Lucaa02/hexatones/Images/BongoCat.jpg

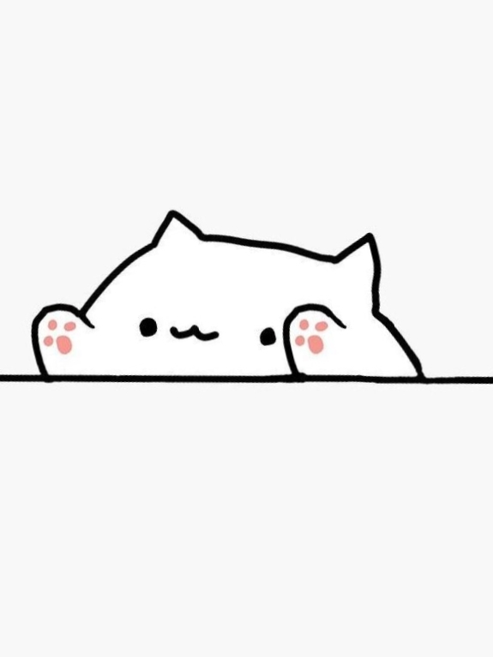
Images/BongoCat.jpg
