Lucaa02/hexatones/Oscillator/Oscillator.pdf

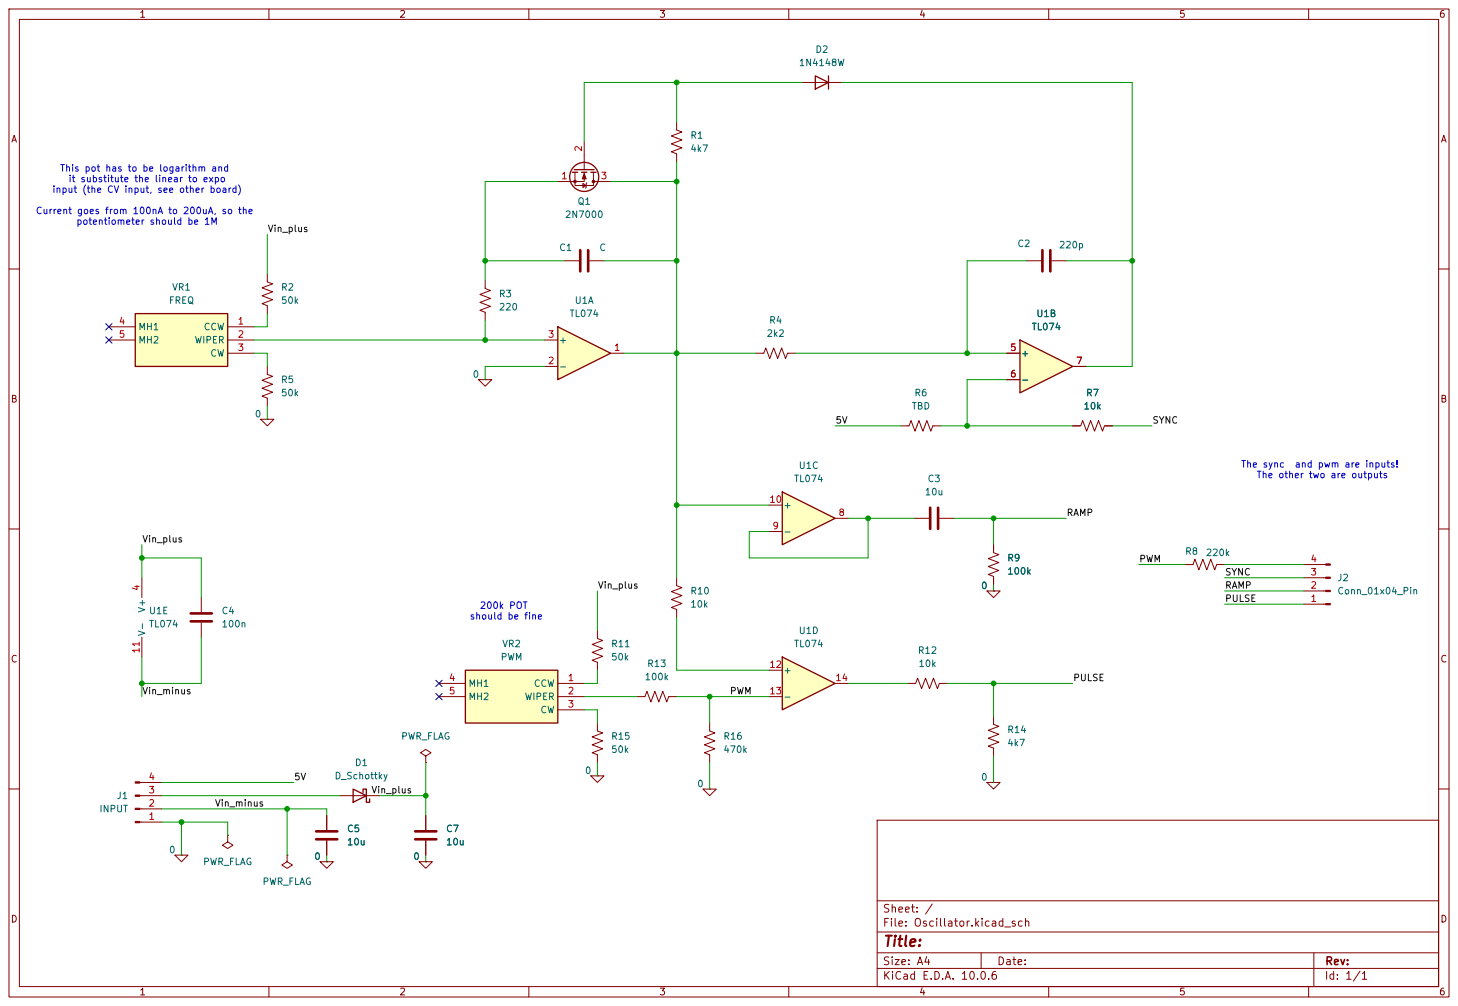
[picture p2: page 1]

This pot has to be logarithm and
it substitute the linear to expo
input (the CV input, see other board) Current goes from 100nA to 200uA, so the potentiometer should be 1M

The sync and pwm are inputs!
The other two are outputs

Size: A4 | Rev:
KiCad E.D.A. 10.0.6 | Id: 1/1
