Lucaa02/hexatones/DCDC/dc-dc-gerbers/dc-dc-schematic.pdf

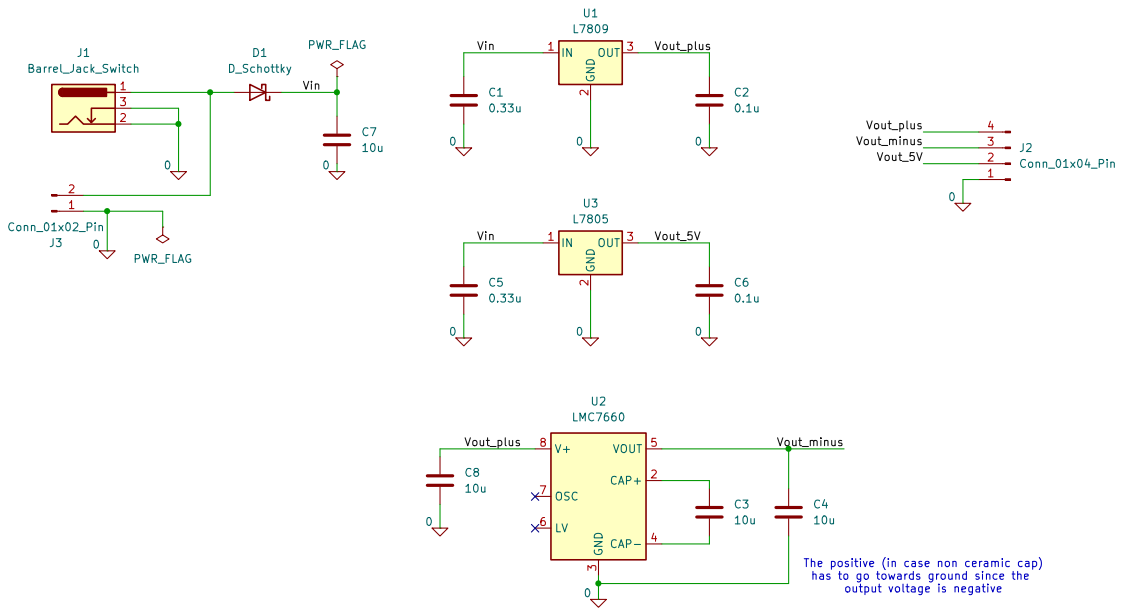
[picture p3: page 1]
