Lucaa02/hexatones/LinearToExp/linear-to-exp.pdf

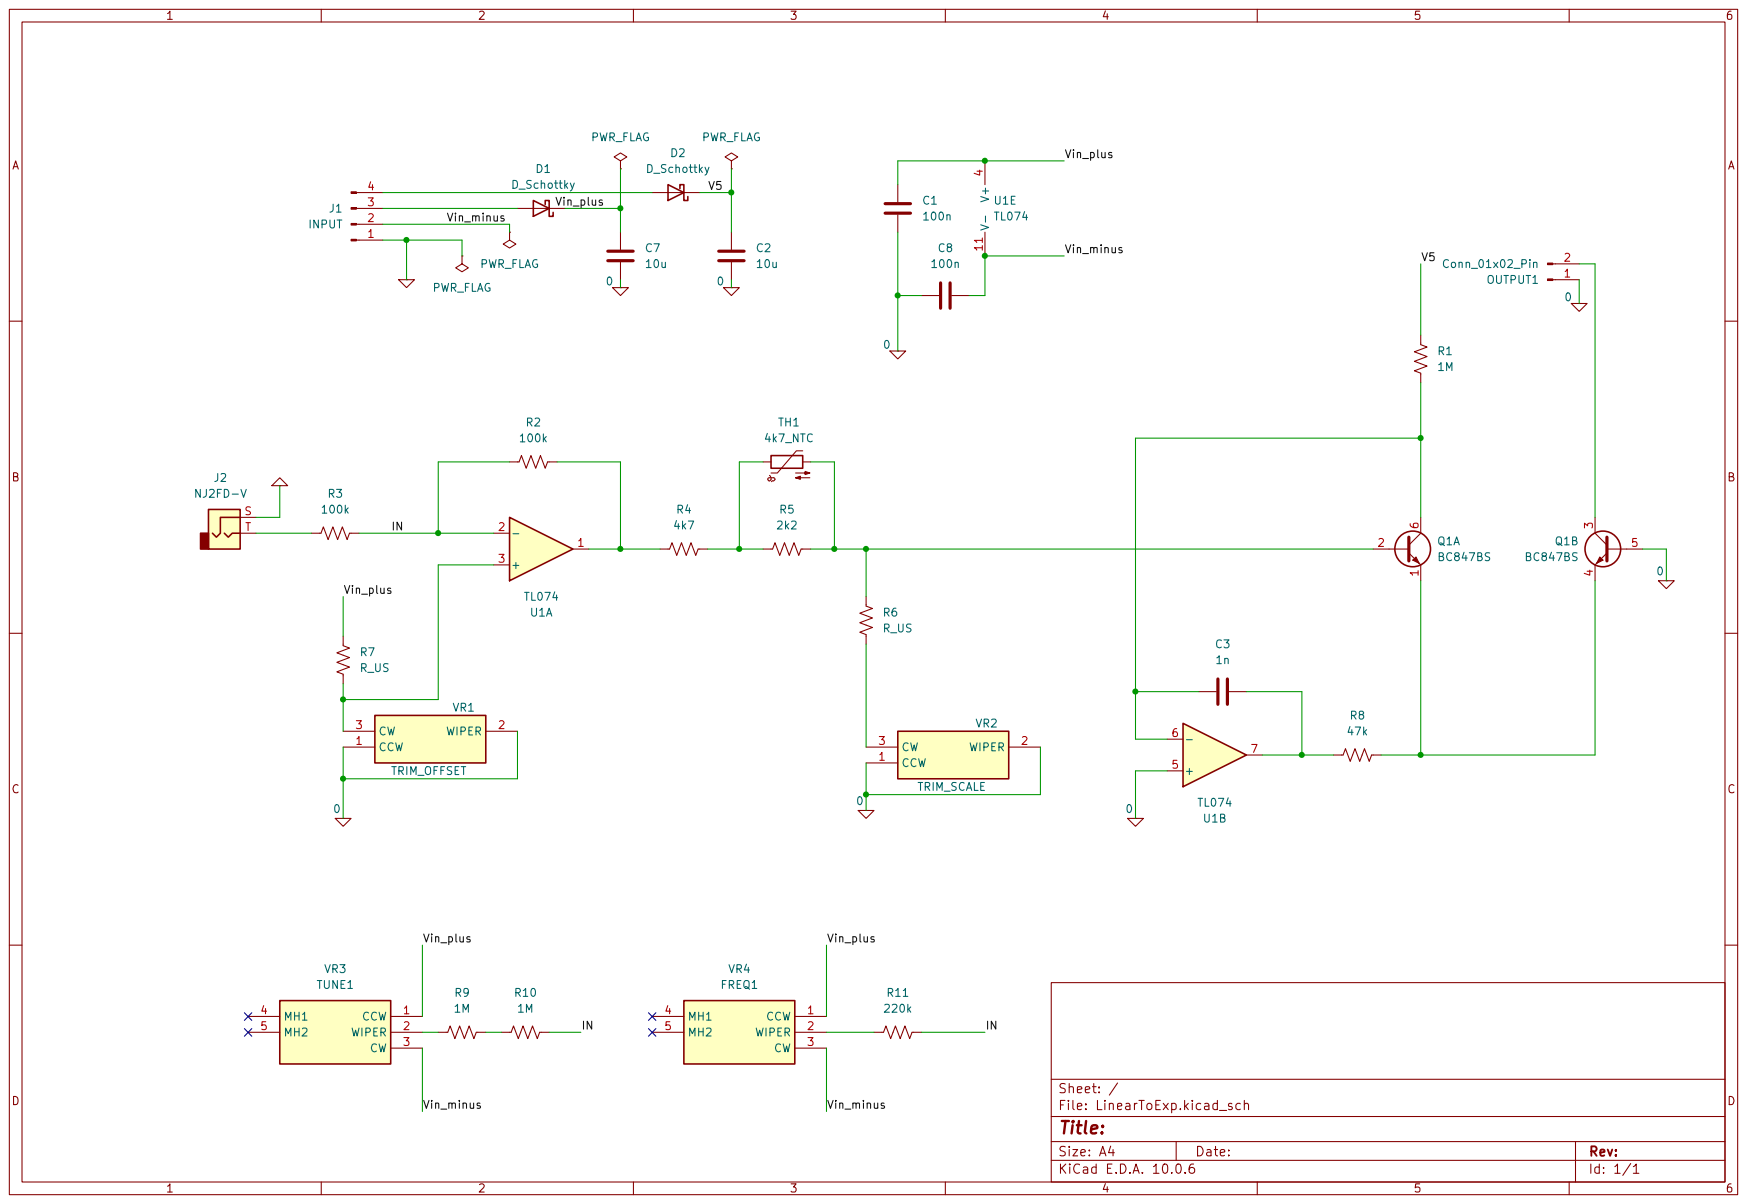
[picture p4: page 1]
