Lucaa02/hexatones/sequencer/sequencer.kicad_pcb

## KiCad design sequencer/sequencer.kicad_pcb (2026-11-05)

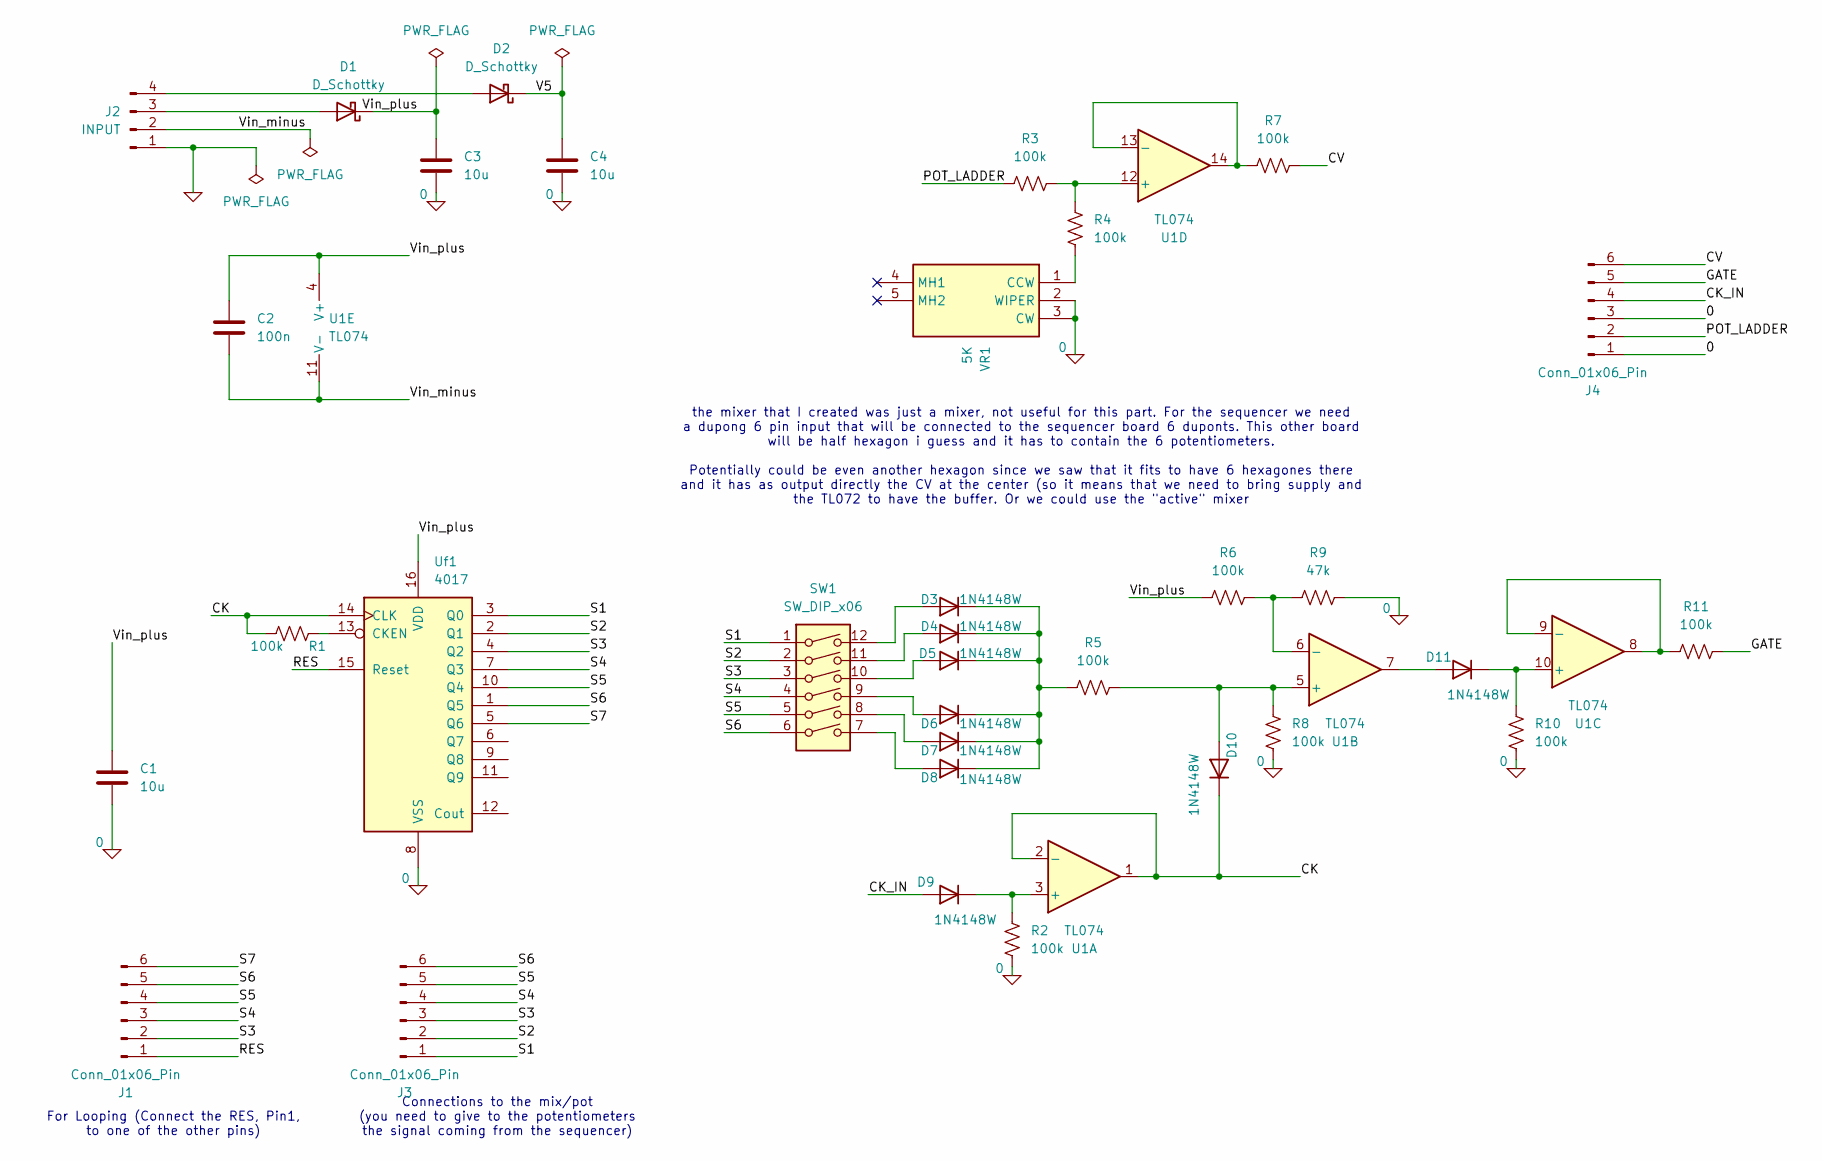
[picture p5: schematic sequencer.kicad_sch]

Parts:
C1, C3, C4: 10u; C_0603_1608Metric_Pad1.08x0.95mm_HandSolder
C2: 100n; C_0603_1608Metric_Pad1.08x0.95mm_HandSolder
D1, D2: D_Schottky; D_SOD-323_HandSoldering
D3, D4, D5, D6, D7, D8, D9, D10, D11: 1N4148W; D_SOD-123
J1, J3, J4: Conn_01x06_Pin; PinHeader_1x06_P2.54mm_Vertical
J2: INPUT; PinHeader_1x04_P2.54mm_Vertical
R1, R2, R3, R4, R5, R6, R7, R8, R10, R11: 100k; R_0603_1608Metric_Pad0.98x0.95mm_HandSolder
R9: 47k; R_0603_1608Metric_Pad0.98x0.95mm_HandSolder
SW1: SW_DIP_x06; SW_DIP_SPSTx06_Slide_9.78x17.42mm_W8.61mm_P2.54mm
U1: TL074; SOIC-14_3.9x8.7mm_P1.27mm
Uf1: 4017; SOIC-16_3.9x9.9mm_P1.27mm
VR1: 5K; Potentiometer_Alpha_RD901F-40-00D_Single_Vertical; Mouser Part Number 311-1940F-15R1-B100K

Connections:
0: C1.2, C3.2, C4.2, J2.1, J4.1, J4.3, R2.1, R8.1, R9.2, R10.1, Uf1.8 (VSS), VR1.2 (WIPER), VR1.3 (CW)
/CK: D10.1 (K), R1.2, U1.1, U1.2 (-), Uf1.14 (CLK)
/CK_IN: D9.2 (A), J4.4
/CV: J4.6, R7.1
/GATE: J4.5, R11.1
/POT_LADDER: J4.2, R3.2
/RES: J1.1, Uf1.15 (Reset)
/S1: J3.1, SW1.1, Uf1.3 (Q0)
/S2: J3.2, SW1.2, Uf1.2 (Q1)
/S3: J1.2, J3.3, SW1.3, Uf1.4 (Q2)
/S4: J1.3, J3.4, SW1.4, Uf1.7 (Q3)
/S5: J1.4, J3.5, SW1.5, Uf1.10 (Q4)
/S6: J1.5, J3.6, SW1.6, Uf1.1 (Q5)
/S7: J1.6, Uf1.5 (Q6)
/V5: C4.1, D2.1 (K)
/Vin_minus: C2.2, J2.2, U1.11 (V-)
/Vin_plus: C1.1, C2.1, C3.1, D1.1 (K), R6.1, U1.4 (V+), Uf1.16 (VDD)
unnamed: D1.2 (A), J2.3
unnamed: D2.2 (A), J2.4
unnamed: D3.2 (A), SW1.12
unnamed: D3.1 (K), D4.1 (K), D5.1 (K), D6.1 (K), D7.1 (K), D8.1 (K), R5.2
unnamed: D4.2 (A), SW1.11
unnamed: D5.2 (A), SW1.10
unnamed: D6.2 (A), SW1.9
unnamed: D7.2 (A), SW1.8
unnamed: D8.2 (A), SW1.7
unnamed: D9.1 (K), R2.2, U1.3 (+)
unnamed: D10.2 (A), R5.1, R8.2, U1.5 (+)
unnamed: D11.2 (A), U1.7
unnamed: D11.1 (K), R10.2, U1.10 (+)
unnamed: R6.2, R9.1, U1.6 (-)
unnamed: R11.2, U1.8, U1.9 (-)
unnamed: R3.1, R4.1, U1.12 (+)
unnamed: R7.2, U1.13 (-), U1.14
unnamed: R1.1, Uf1.13 (CKEN)
unnamed: R4.2, VR1.1 (CCW)

Notes on the sheet:
For Looping (Connect the RES, Pin1, to one of the other pins)
Connections to the mix/pot (you need to give to the potentiometers the signal coming from the sequencer)
the mixer that I created was just a mixer, not useful for this part. For the sequencer we need a dupong 6 pin input that will be connected to the sequencer board 6 duponts. This other board will be half hexagon i guess and it has to contain the 6 potentiometers. Potentially could be even another he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

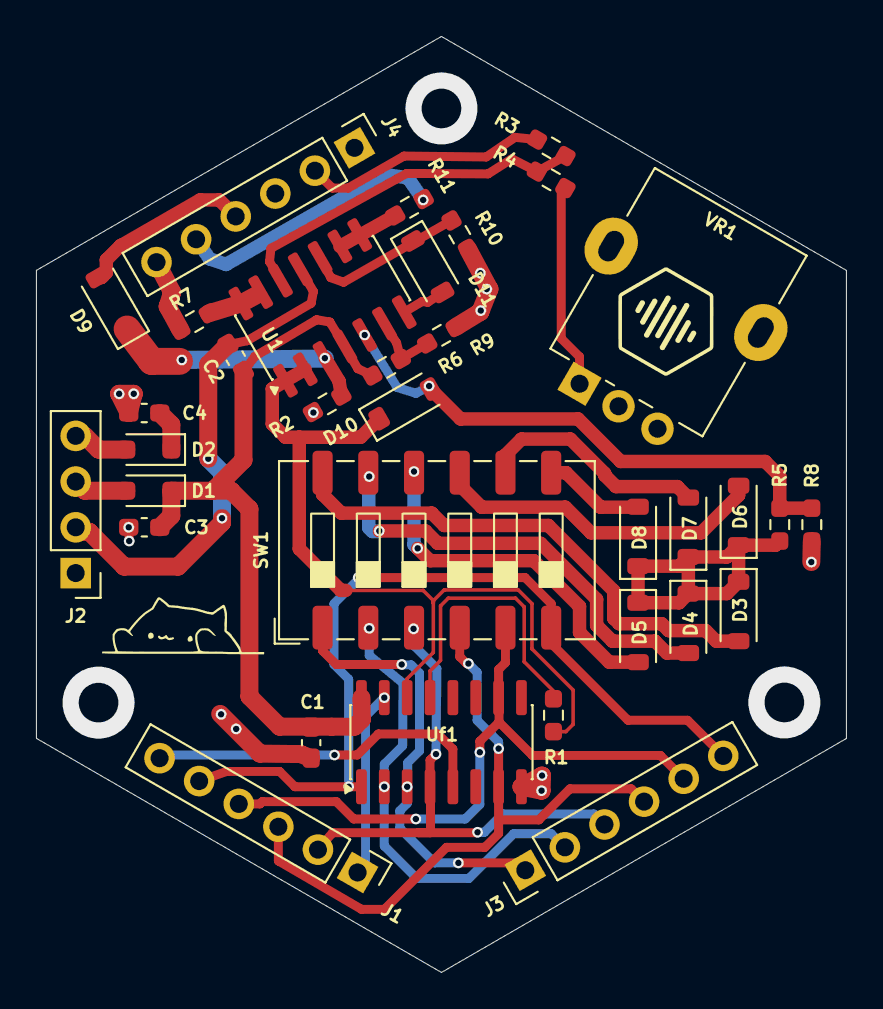
[picture p6: board sequencer.kicad_pcb from above]

Board: 2 copper layers, 45.0 x 52.0 mm, 34 parts (0 on the bottom side), 36 nets.
