Lucaa02/hexatones/clk/clk.kicad_pcb

## KiCad design clk/clk.kicad_pcb (2026-11-03)

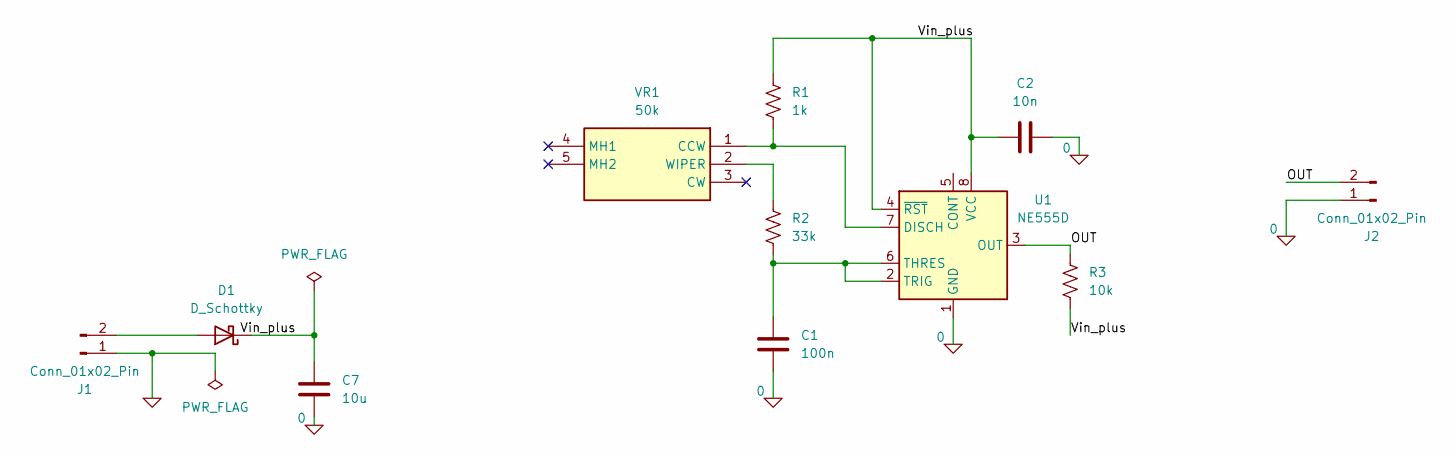
[picture p7: schematic clk.kicad_sch]

Parts:
C1: 100n; C_0603_1608Metric_Pad1.08x0.95mm_HandSolder
C2: 10n; C_0603_1608Metric_Pad1.08x0.95mm_HandSolder
C7: 10u; C_0603_1608Metric_Pad1.08x0.95mm_HandSolder
D1: D_Schottky; D_SOD-323_HandSoldering
J1, J2: Conn_01x02_Pin; PinHeader_1x02_P2.54mm_Vertical
R1: 1k; R_0603_1608Metric_Pad0.98x0.95mm_HandSolder
R2: 33k; R_0603_1608Metric_Pad0.98x0.95mm_HandSolder
R3: 10k; R_0603_1608Metric_Pad0.98x0.95mm_HandSolder
U1: NE555D; SOIC-8_3.9x4.9mm_P1.27mm
VR1: 50k; PinHeader_1x03_P2.54mm_Vertical; Mouser Part Number 311-1940F-15R1-B100K

Connections:
0: C1.2, C2.2, C7.2, J1.1, J2.1, U1.1 (GND)
/OUT: J2.2, R3.2, U1.3 (OUT)
/Vin_plus: C2.1, C7.1, D1.1 (K), R1.2, R3.1, U1.4 (~RST), U1.8 (VCC)
unnamed: D1.2 (A), J1.2
unnamed 4: R1.1, U1.7 (DISCH), VR1.1 (CCW); also elsewhere on the board
unnamed: C1.1, R2.1, U1.2 (TRIG), U1.6 (THRES)
unnamed 6: R2.2, VR1.2 (WIPER); also elsewhere on the board

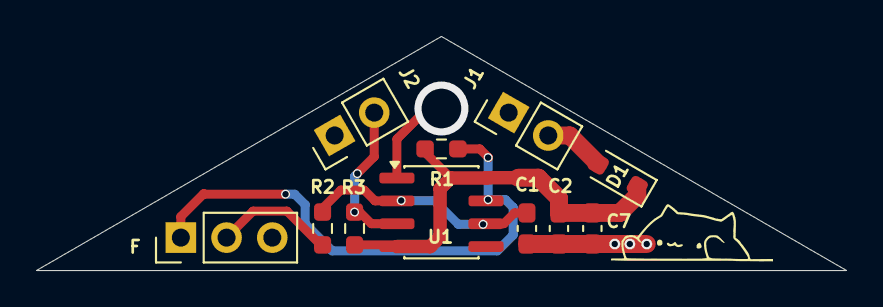
[picture p8: board clk.kicad_pcb from above]

Board: 2 copper layers, 45.0 x 13.0 mm, 11 parts (0 on the bottom side), 7 nets.

Other parts of the board:
F: 50k; PinHeader_1x03_P2.54mm_Vertical

Their connections:
unnamed 4: F.1 (CCW); also elsewhere on the board
unnamed 6: F.2 (WIPER); also elsewhere on the board
