Lucaa02/hexatones/passivemixer/passivemixer.kicad_pcb

## KiCad design passivemixer/passivemixer.kicad_pcb (2026-11-03)

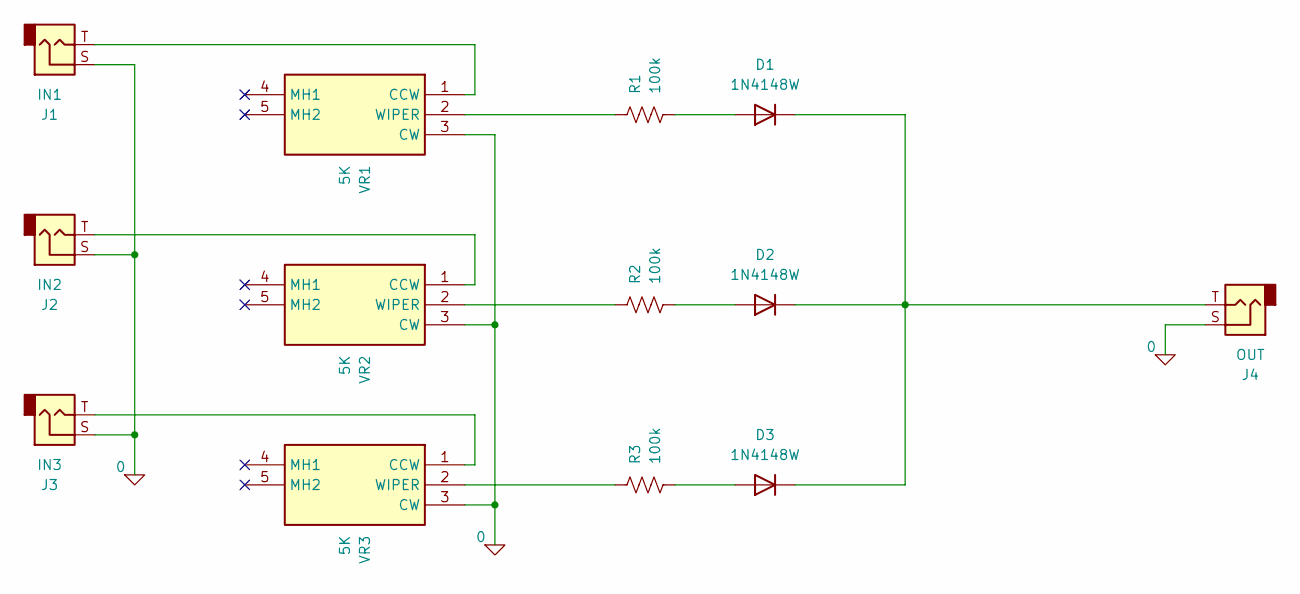
[picture p9: schematic passivemixer.kicad_sch]

Parts:
D1, D2, D3: 1N4148W; D_SOD-123
J1: IN1; Jack_3.5mm_QingPu_WQP-PJ398SM_Vertical_CircularHoles
J2: IN2; Jack_3.5mm_QingPu_WQP-PJ398SM_Vertical_CircularHoles
J3: IN3; Jack_3.5mm_QingPu_WQP-PJ398SM_Vertical_CircularHoles
J4: OUT; Jack_3.5mm_QingPu_WQP-PJ398SM_Vertical_CircularHoles
R1, R2, R3: 100k; R_0603_1608Metric_Pad0.98x0.95mm_HandSolder
VR1, VR2, VR3: 5K; Potentiometer_Alpha_RD901F-40-00D_Single_Vertical; Mouser Part Number 311-1940F-15R1-B100K

Connections:
0: J1.S, J2.S, J3.S, J4.S, VR1.3 (CW), VR2.3 (CW), VR3.3 (CW)
unnamed: D1.2 (A), R1.2
unnamed: D1.1 (K), D2.1 (K), D3.1 (K), J4.T
unnamed: D2.2 (A), R2.2
unnamed: D3.2 (A), R3.2
unnamed: J1.T, VR1.1 (CCW)
unnamed: R1.1, VR1.2 (WIPER)
unnamed: J2.T, VR2.1 (CCW)
unnamed: R2.1, VR2.2 (WIPER)
unnamed: J3.T, VR3.1 (CCW)
unnamed: R3.1, VR3.2 (WIPER)

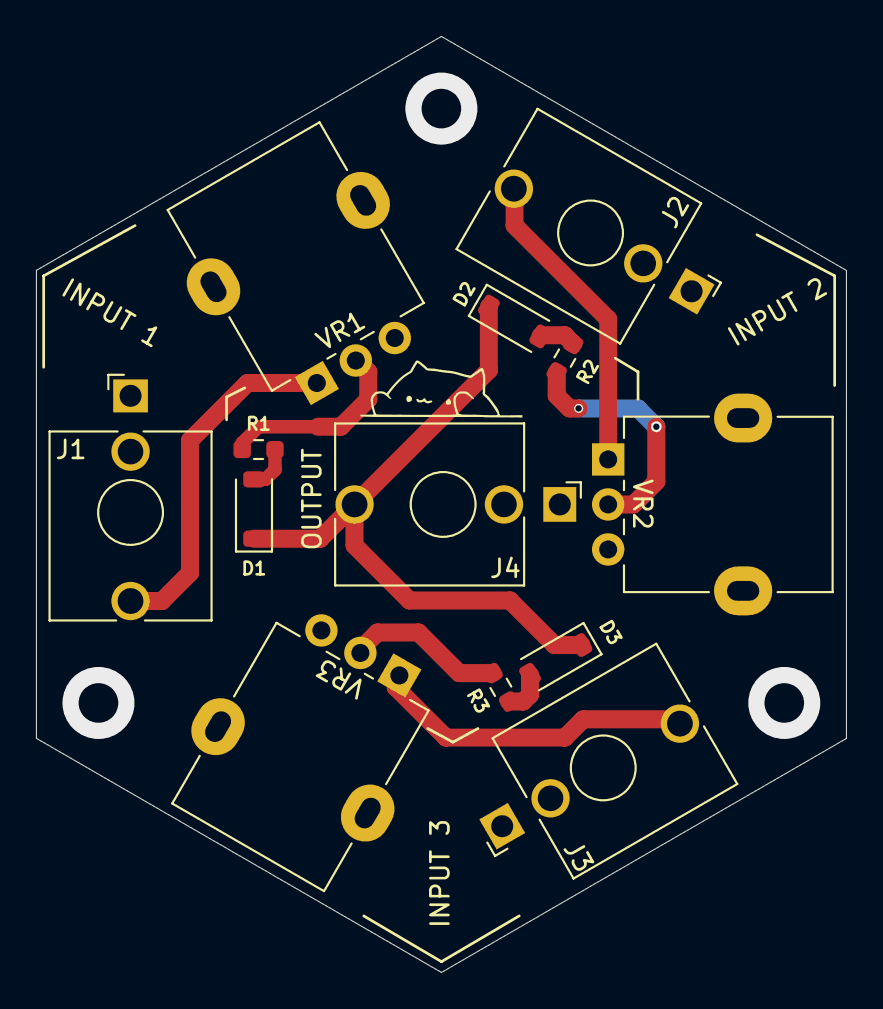
[picture p10: board passivemixer.kicad_pcb from above]

Board: 2 copper layers, 45.0 x 52.0 mm, 13 parts (0 on the bottom side), 11 nets.
