Lucaa02/hexatones/vca/vca.kicad_pcb

## KiCad design vca/vca.kicad_pcb (2026-11-03)

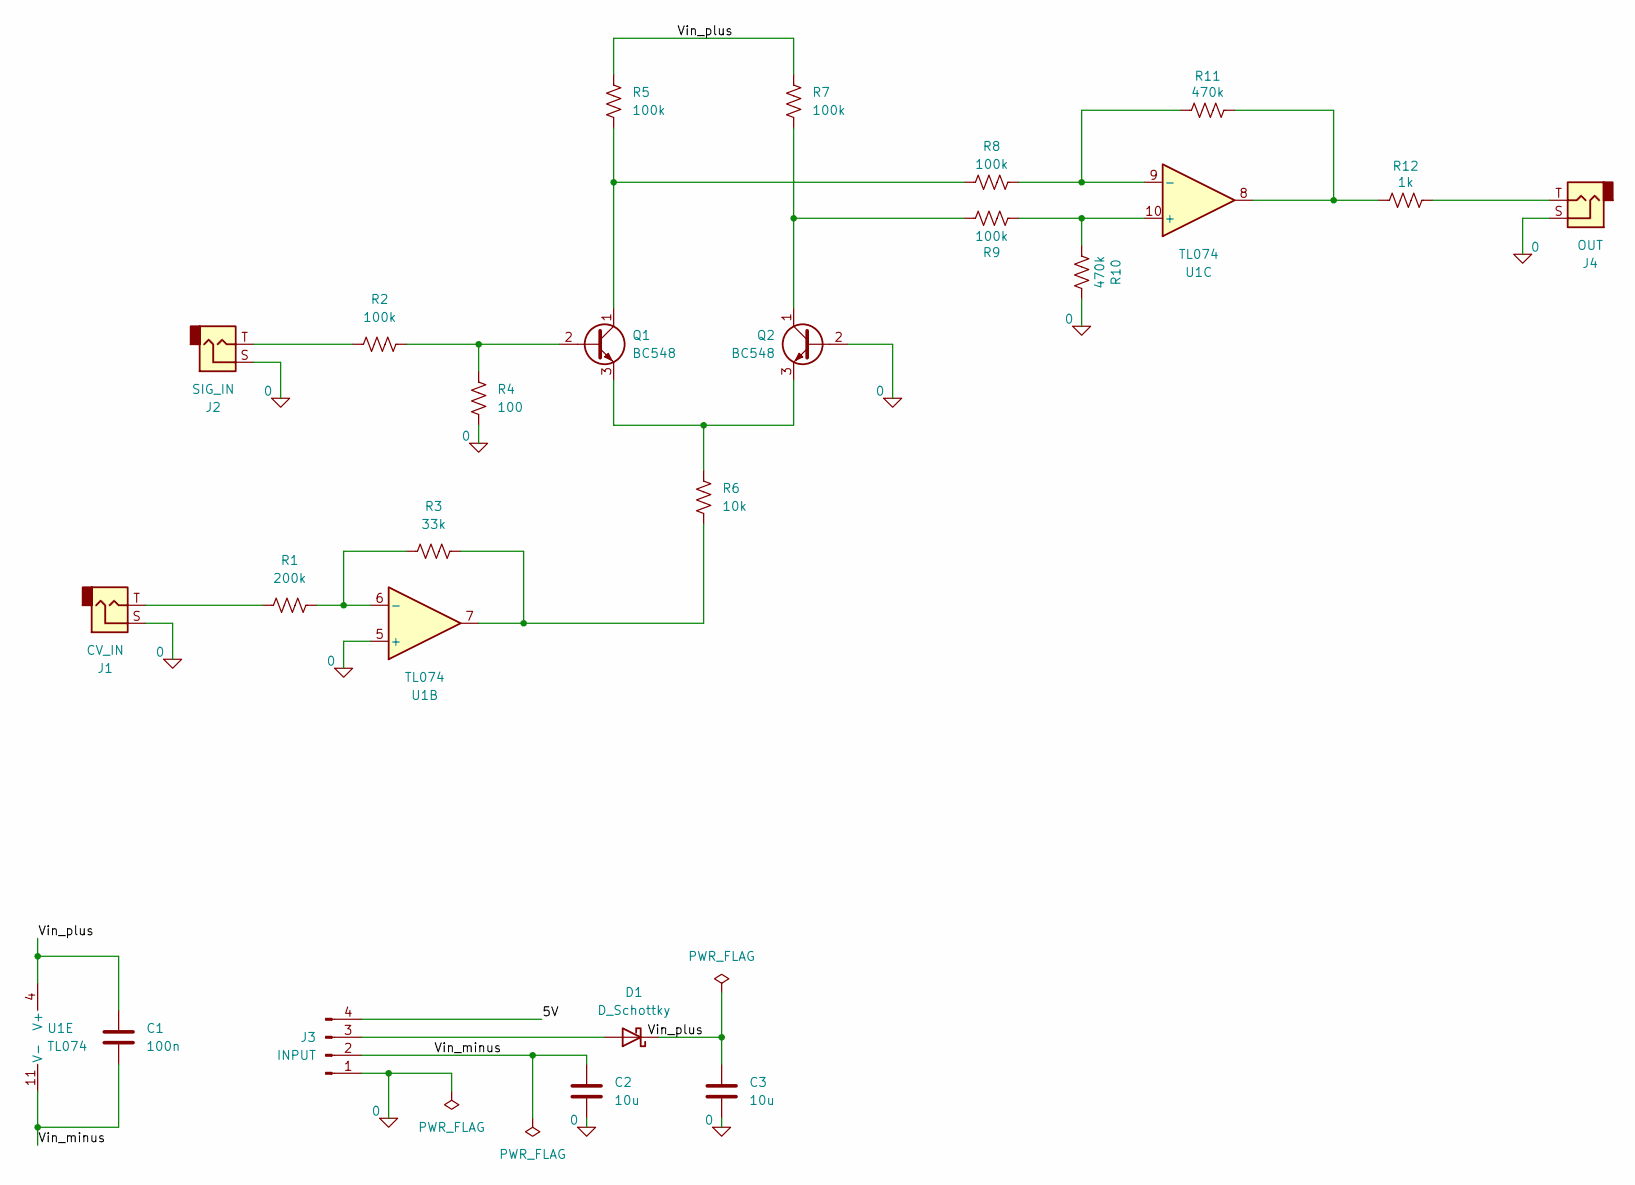
[picture p11: schematic vca.kicad_sch]

Parts:
C1: 100n; C_0603_1608Metric_Pad1.08x0.95mm_HandSolder
C2, C3: 10u; C_0603_1608Metric_Pad1.08x0.95mm_HandSolder
D1: D_Schottky; D_SOD-323_HandSoldering
J1: CV_IN; Jack_3.5mm_QingPu_WQP-PJ398SM_Vertical_CircularHoles
J2: SIG_IN; Jack_3.5mm_QingPu_WQP-PJ398SM_Vertical_CircularHoles
J3: INPUT; PinHeader_1x04_P2.54mm_Vertical
J4: OUT; Jack_3.5mm_QingPu_WQP-PJ398SM_Vertical_CircularHoles
Q1, Q2: BC548; TO-92_Inline
R1: 200k; R_0603_1608Metric_Pad0.98x0.95mm_HandSolder
R2, R5, R7, R8, R9: 100k; R_0603_1608Metric_Pad0.98x0.95mm_HandSolder
R3: 33k; R_0603_1608Metric_Pad0.98x0.95mm_HandSolder
R4: 100; R_0603_1608Metric_Pad0.98x0.95mm_HandSolder
R6: 10k; R_0603_1608Metric_Pad0.98x0.95mm_HandSolder
R10, R11: 470k; R_0603_1608Metric_Pad0.98x0.95mm_HandSolder
R12: 1k; R_0603_1608Metric_Pad0.98x0.95mm_HandSolder
U1: TL074; SOIC-14_3.9x8.7mm_P1.27mm

Connections:
0: C2.2, C3.2, J1.S, J2.S, J3.1, J4.S, Q2.2 (B), R4.1, R10.1, U1.5 (+)
/5V: J3.4
/Vin_minus: C1.2, C2.1, J3.2, U1.11 (V-)
/Vin_plus: C1.1, C3.1, D1.1 (K), R5.1, R7.1, U1.4 (V+)
unnamed: D1.2 (A), J3.3
unnamed: J1.T, R1.1
unnamed: J2.T, R2.2
unnamed: J4.T, R12.1
unnamed: Q1.2 (B), R2.1, R4.2
unnamed: Q1.1 (C), R5.2, R8.2
unnamed: Q1.3 (E), Q2.3 (E), R6.2
unnamed: Q2.1 (C), R7.2, R9.1
unnamed: R3.2, R6.1, U1.7
unnamed: R11.1, R12.2, U1.8
unnamed: R1.2, R3.1, U1.6 (-)
unnamed: R9.2, R10.2, U1.10 (+)
unnamed: R8.1, R11.2, U1.9 (-)

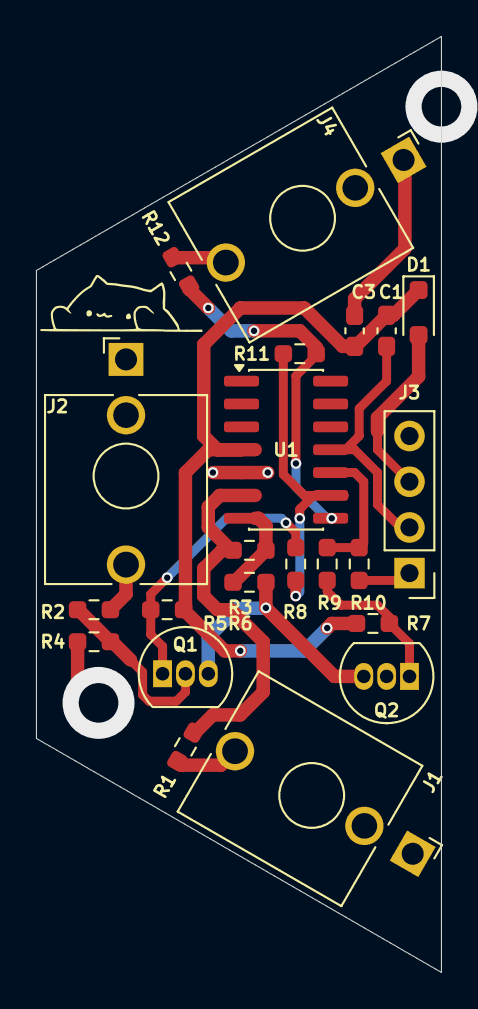
[picture p12: board vca.kicad_pcb from above]

Board: 2 copper layers, 22.5 x 52.0 mm, 22 parts (0 on the bottom side), 16 nets.
