Lucaa02/hexatones/Oscillator/Oscillator.kicad_pcb

## KiCad design Oscillator/Oscillator.kicad_pcb (2026-11-03)

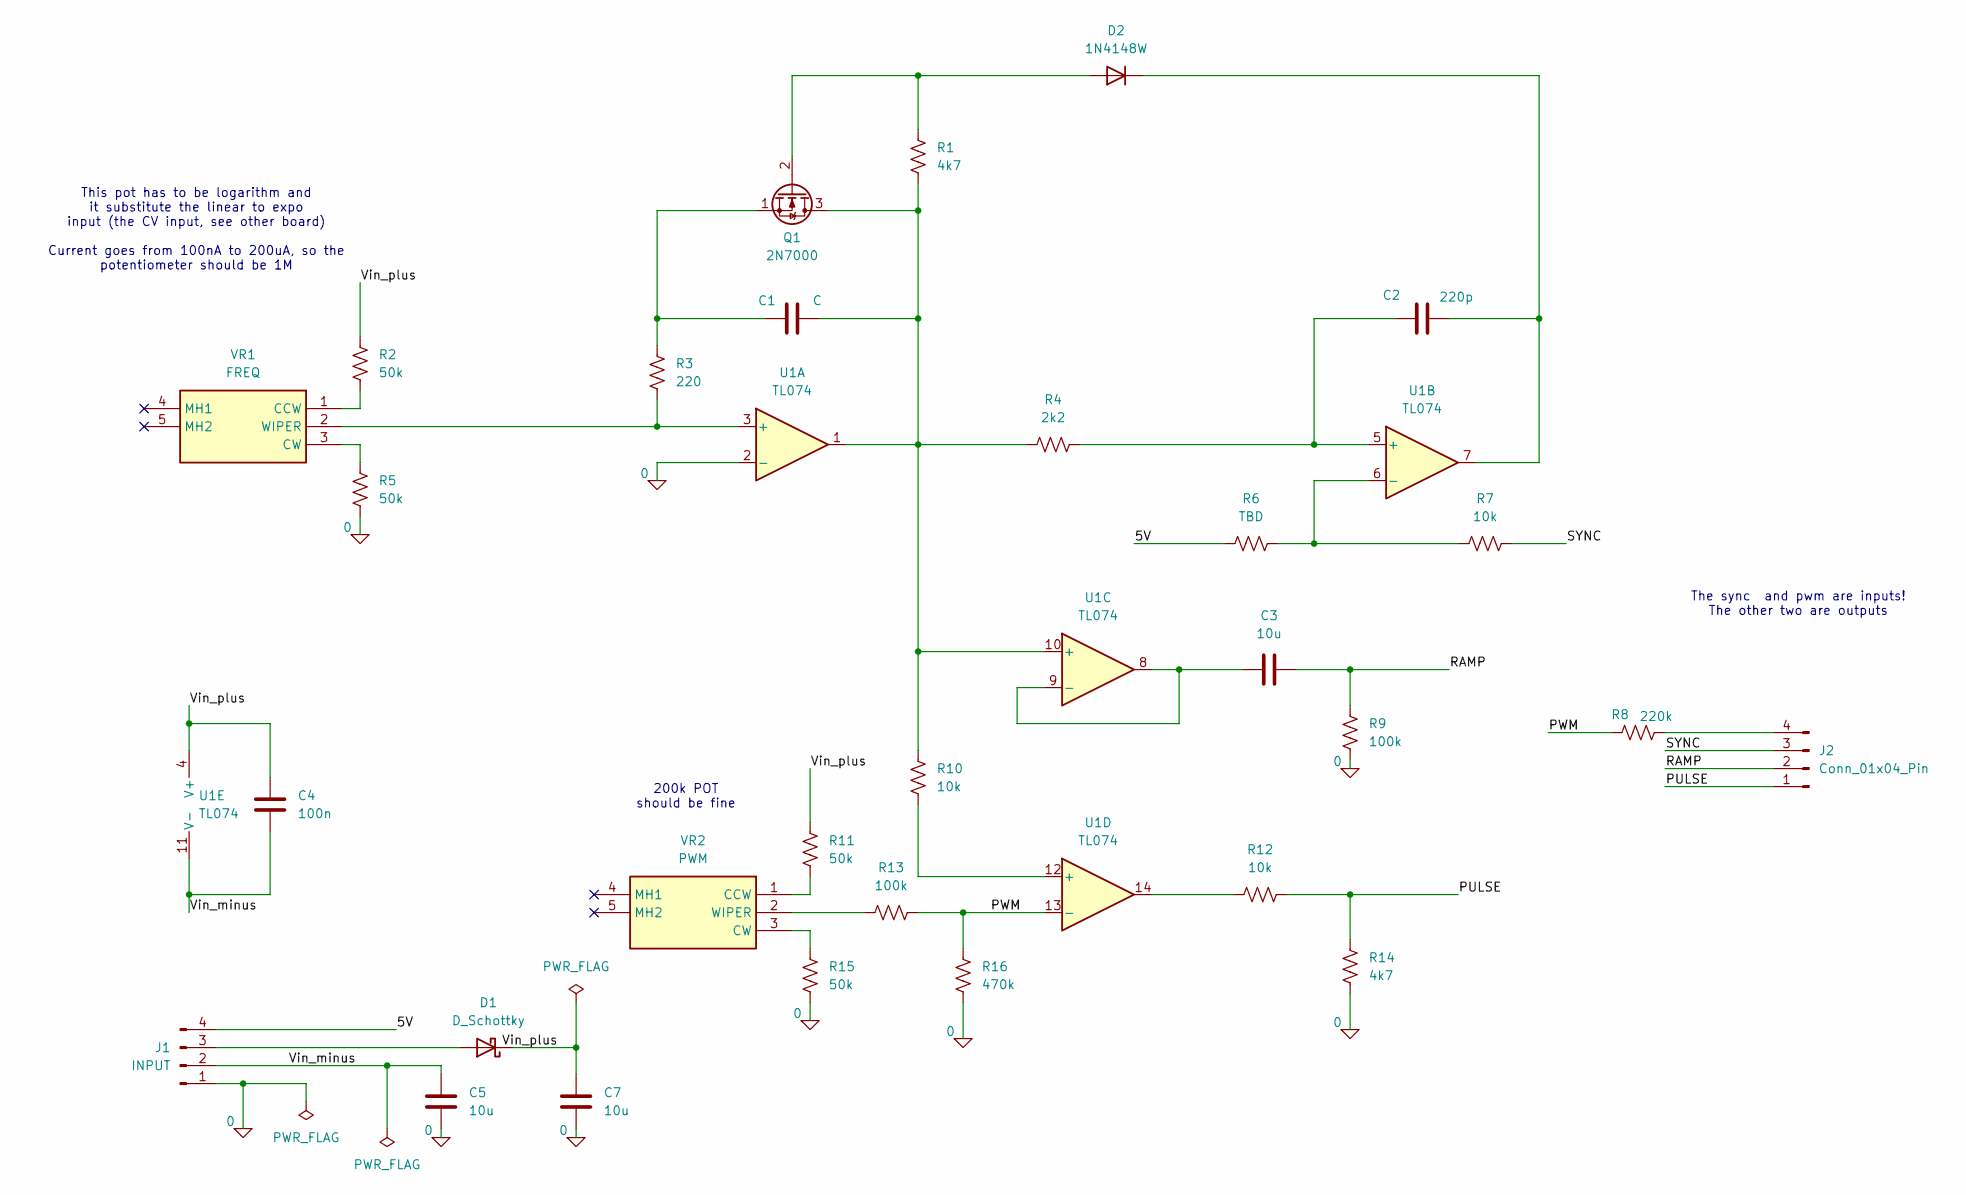
[picture p13: schematic Oscillator.kicad_sch]

Parts:
C1: C; C_0603_1608Metric_Pad1.08x0.95mm_HandSolder
C2: 220p; C_0603_1608Metric_Pad1.08x0.95mm_HandSolder
C3, C5, C7: 10u; C_0603_1608Metric_Pad1.08x0.95mm_HandSolder
C4: 100n; C_0603_1608Metric_Pad1.08x0.95mm_HandSolder
D1: D_Schottky; D_SOD-323_HandSoldering
D2: 1N4148W; D_SOD-123
J1: INPUT; PinHeader_1x04_P2.54mm_Vertical
J2: Conn_01x04_Pin; PinHeader_1x04_P2.54mm_Vertical
Q1: 2N7000; TO-92_Inline
R1: 4k7; C_0603_1608Metric_Pad1.08x0.95mm_HandSolder
R2, R5, R11, R15: 50k; R_0603_1608Metric_Pad0.98x0.95mm_HandSolder
R3: 220; R_0603_1608Metric_Pad0.98x0.95mm_HandSolder
R4: 2k2; R_0603_1608Metric_Pad0.98x0.95mm_HandSolder
R6: TBD; R_0603_1608Metric_Pad0.98x0.95mm_HandSolder
R7, R10, R12: 10k; R_0603_1608Metric_Pad0.98x0.95mm_HandSolder
R8: 220k; R_0603_1608Metric_Pad0.98x0.95mm_HandSolder
R9, R13: 100k; R_0603_1608Metric_Pad0.98x0.95mm_HandSolder
R14: 4k7; R_0603_1608Metric_Pad0.98x0.95mm_HandSolder
R16: 470k; R_0603_1608Metric_Pad0.98x0.95mm_HandSolder
U1: TL074; SOIC-14_3.9x8.7mm_P1.27mm
VR1: FREQ; Potentiometer_Alpha_RD901F-40-00D_Single_Vertical; Mouser Part Number 311-1940F-15R1-B100K
VR2: PWM; Potentiometer_Alpha_RD901F-40-00D_Single_Vertical; Mouser Part Number 311-1940F-15R1-B100K

Connections:
0: C5.2, C7.2, J1.1, R5.2, R9.1, R14.1, R15.2, R16.1, U1.2 (-)
/5V: J1.4, R6.1
/PULSE: J2.1, R12.1, R14.2
/PWM: R8.1, R13.2, R16.2, U1.13 (-)
/RAMP: C3.2, J2.2, R9.2
/SYNC: J2.3, R7.2
/Vin_minus: C4.2, C5.1, J1.2, U1.11 (V-)
/Vin_plus: C4.1, C7.1, D1.1 (K), R2.1, R11.1, U1.4 (V+)
unnamed: D1.2 (A), J1.3
unnamed: D2.2 (A), Q1.2 (G), R1.2
unnamed: C2.2, D2.1 (K), U1.7
unnamed: J2.4, R8.2
unnamed: C1.2, Q1.3 (D), R1.1, R4.1, R10.1, U1.1, U1.10 (+)
unnamed: C1.1, Q1.1 (S), R3.1
unnamed: R12.2, U1.14
unnamed: R3.2, U1.3 (+), VR1.2 (WIPER)
unnamed: C2.1, R4.2, U1.5 (+)
unnamed: R6.2, R7.1, U1.6 (-)
unnamed: C3.1, U1.8, U1.9 (-)
unnamed: R10.2, U1.12 (+)
unnamed: R2.2, VR1.1 (CCW)
unnamed: R5.1, VR1.3 (CW)
unnamed: R11.2, VR2.1 (CCW)
unnamed: R15.1, VR2.3 (CW)
unnamed: R13.1, VR2.2 (WIPER)

Notes on the sheet:
This pot has to be logarithm and it substitute the linear to expo input (the CV input, see other board) Current goes from 100nA to 200uA, so the potentiometer should be 1M
The sync and pwm are inputs! The other two are outputs
200k POT should be fine

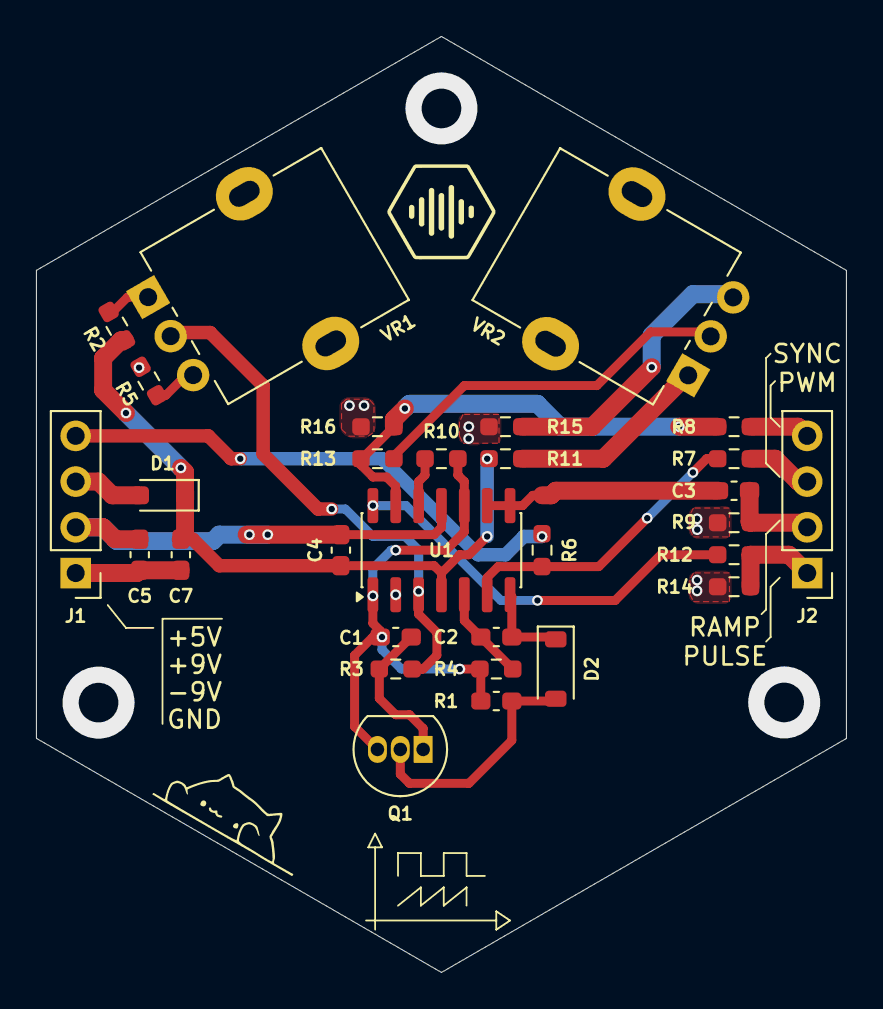
[picture p14: board Oscillator.kicad_pcb from above]

Board: 2 copper layers, 45.0 x 52.0 mm, 30 parts (0 on the bottom side), 25 nets.
