Lucaa02/hexatones/LinearToExp/LinearToExp.kicad_pcb

## KiCad design LinearToExp/LinearToExp.kicad_pcb (2026-11-03)

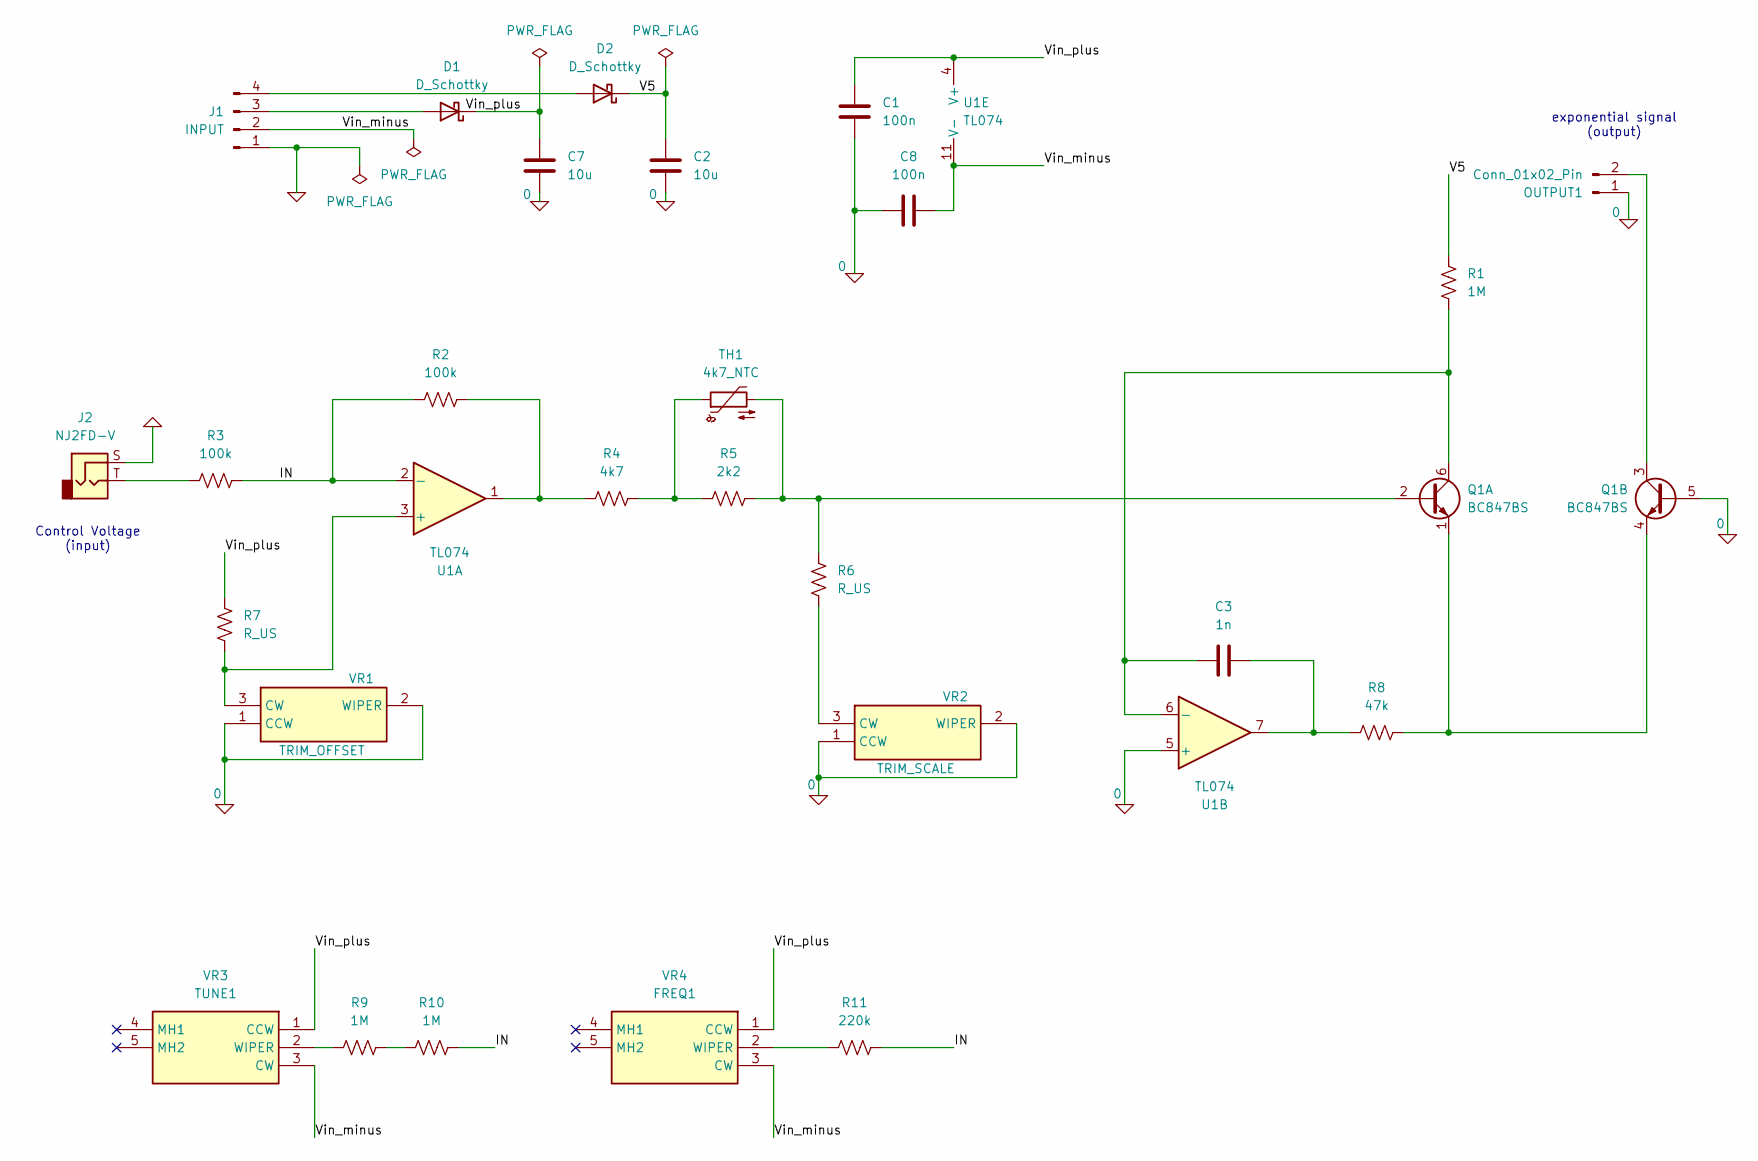
[picture p15: schematic LinearToExp.kicad_sch]

Parts:
C1, C8: 100n; C_0603_1608Metric_Pad1.08x0.95mm_HandSolder
C2, C7: 10u; C_0603_1608Metric_Pad1.08x0.95mm_HandSolder
C3: 1n; C_0603_1608Metric_Pad1.08x0.95mm_HandSolder
D1, D2: D_Schottky; D_SOD-323_HandSoldering
J1: INPUT; PinHeader_1x04_P2.54mm_Vertical
J2: NJ2FD-V; Jack_3.5mm_QingPu_WQP-PJ398SM_Vertical_CircularHoles
OUTPUT1: Conn_01x02_Pin; PinHeader_1x02_P2.54mm_Vertical
Q1: BC847BS; SOT-363_SC-70-6
R1, R9, R10: 1M; R_0603_1608Metric_Pad0.98x0.95mm_HandSolder
R2, R3: 100k; R_0603_1608Metric_Pad0.98x0.95mm_HandSolder
R4: 4k7; R_0603_1608Metric_Pad0.98x0.95mm_HandSolder
R5: 2k2; R_0603_1608Metric_Pad0.98x0.95mm_HandSolder
R6, R7: R_US; R_0603_1608Metric_Pad0.98x0.95mm_HandSolder
R8: 47k; R_0603_1608Metric_Pad0.98x0.95mm_HandSolder
R11: 220k; R_0603_1608Metric_Pad0.98x0.95mm_HandSolder
TH1: 4k7_NTC; R_Axial_DIN0204_L3.6mm_D1.6mm_P2.54mm_Vertical
U1: TL074; SOIC-14_3.9x8.7mm_P1.27mm
VR1: TRIM_OFFSET; Potentiometer_Bourns_3314J_Vertical; Mouser Part Number 652-3314J-1-104E
VR2: TRIM_SCALE; Potentiometer_Bourns_3314J_Vertical; Mouser Part Number 652-3314J-1-104E
VR3: TUNE1; Potentiometer_Alpha_RD901F-40-00D_Single_Vertical; Mouser Part Number 311-1940F-15R1-B100K
VR4: FREQ1; Potentiometer_Alpha_RD901F-40-00D_Single_Vertical; Mouser Part Number 311-1940F-15R1-B100K

Connections:
0: C1.2, C2.2, C7.2, C8.1, J1.1, J2.S, OUTPUT1.1, Q1.5 (B2), U1.5 (+), VR1.1 (CCW), VR1.2 (WIPER), VR2.1 (CCW), VR2.2 (WIPER)
/IN: R2.1, R3.2, R10.2, R11.2, U1.2 (-)
/V5: C2.1, D2.1 (K), R1.1
/Vin_minus: C8.2, J1.2, U1.11 (V-), VR3.3 (CW), VR4.3 (CW)
/Vin_plus: C1.1, C7.1, D1.1 (K), R7.1, U1.4 (V+), VR3.1 (CCW), VR4.1 (CCW)
unnamed: C3.2, R8.2, U1.7
unnamed: D1.2 (A), J1.3
unnamed: D2.2 (A), J1.4
unnamed: J2.T, R3.1
unnamed: OUTPUT1.2, Q1.3 (C2)
unnamed: Q1.2 (B1), R5.2, R6.2, TH1.2
unnamed: C3.1, Q1.6 (C1), R1.2, U1.6 (-)
unnamed: Q1.1 (E1), Q1.4 (E2), R8.1
unnamed: R2.2, R4.1, U1.1
unnamed: R4.2, R5.1, TH1.1
unnamed: R9.2, R10.1
unnamed: R7.2, U1.3 (+), VR1.3 (CW)
unnamed: R6.1, VR2.3 (CW)
unnamed: R9.1, VR3.2 (WIPER)
unnamed: R11.1, VR4.2 (WIPER)

Notes on the sheet:
exponential signal (output)
Control Voltage (input)

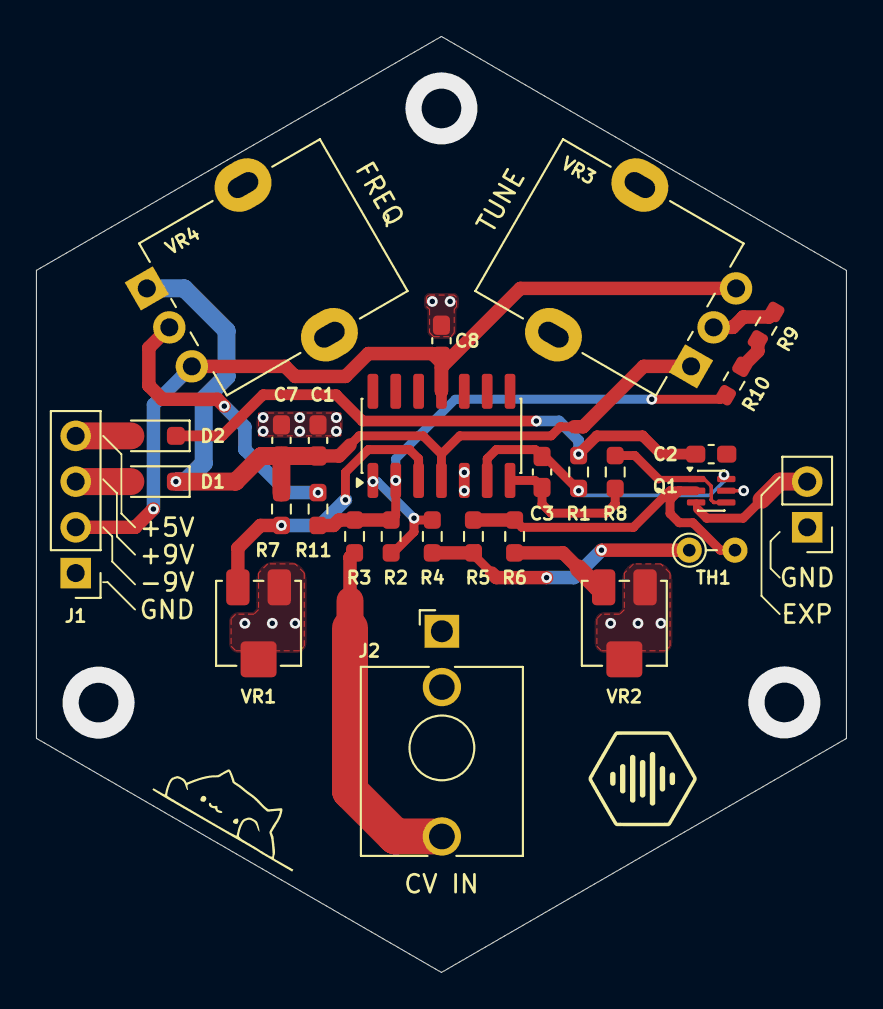
[picture p16: board LinearToExp.kicad_pcb from above]

Board: 2 copper layers, 45.0 x 52.0 mm, 28 parts (0 on the bottom side), 20 nets.
