Lucaa02/hexatones/DCDC/dcdc.kicad_pcb

## KiCad design DCDC/dcdc.kicad_pcb (2026-11-03)

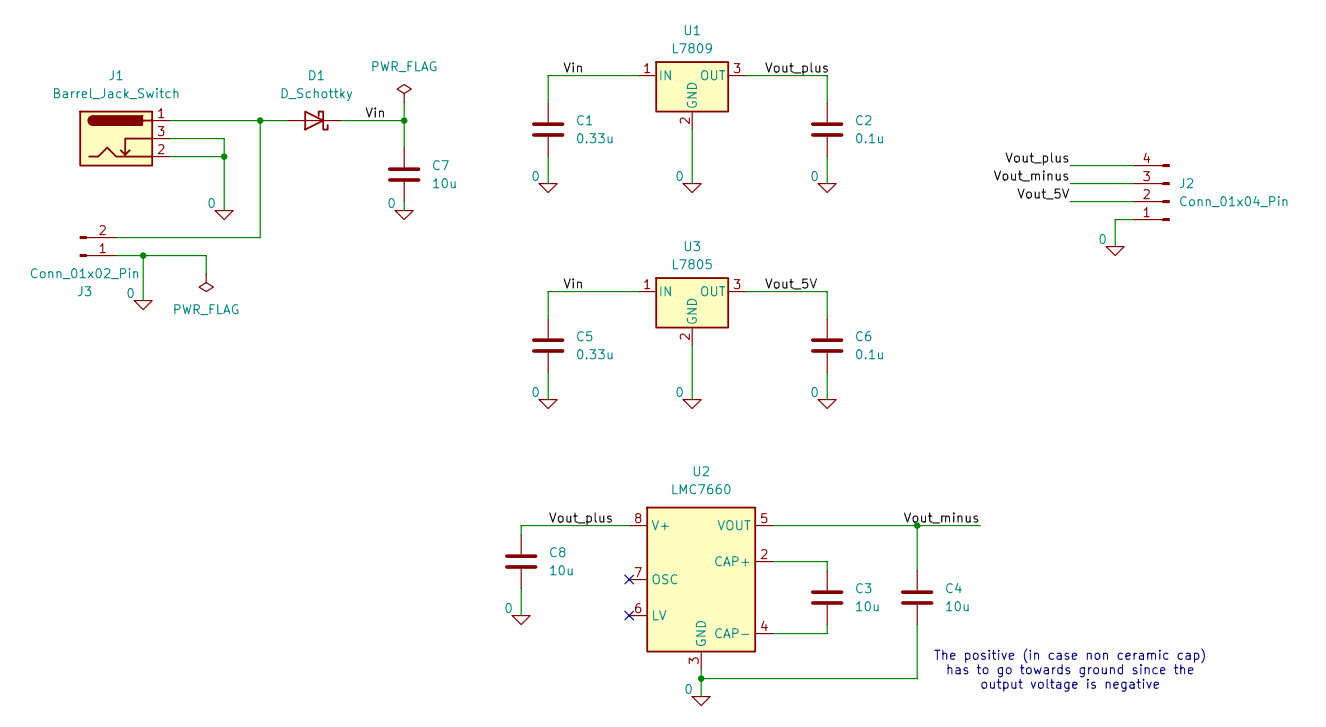
[picture p17: schematic dcdc.kicad_sch]

Parts:
C1, C5: 0.33u; C_0603_1608Metric_Pad1.08x0.95mm_HandSolder
C2, C6: 0.1u; C_0603_1608Metric_Pad1.08x0.95mm_HandSolder
C3, C4, C7, C8: 10u; C_0603_1608Metric_Pad1.08x0.95mm_HandSolder
D1: D_Schottky; D_SOD-323_HandSoldering
J1: Barrel_Jack_Switch; BarrelJack_Wuerth_694106106102_2.0x5.5mm
J2: Conn_01x04_Pin; PinHeader_1x04_P2.54mm_Vertical
J3: Conn_01x02_Pin; PinHeader_1x02_P2.54mm_Vertical
U1: L7809; TO-263-2
U2: LMC7660; SOIC-8_3.9x4.9mm_P1.27mm
U3: L7805; TO-263-2

Connections:
0: C1.2, C2.2, C4.2, C5.2, C6.2, C7.2, C8.2, J1.2, J1.3, J2.1, J3.1, U1.2 (GND), U2.3 (GND), U3.2 (GND)
/Vin: C1.1, C5.1, C7.1, D1.1 (K), U1.1 (IN), U3.1 (IN)
/Vout_5V: C6.1, J2.2, U3.3 (OUT)
/Vout_minus: C4.1, J2.3, U2.5 (VOUT)
/Vout_plus: C2.1, C8.1, J2.4, U1.3 (OUT), U2.8 (V+)
unnamed: D1.2 (A), J1.1, J3.2
unnamed: C3.1, U2.2 (CAP+)
unnamed: C3.2, U2.4 (CAP-)

Notes on the sheet:
The positive (in case non ceramic cap) has to go towards ground since the output voltage is negative
