Lucaa02/hexatones/DCDC/dcdc.kicad_pcb

## KiCad design DCDC/dcdc.kicad_pcb (continued)

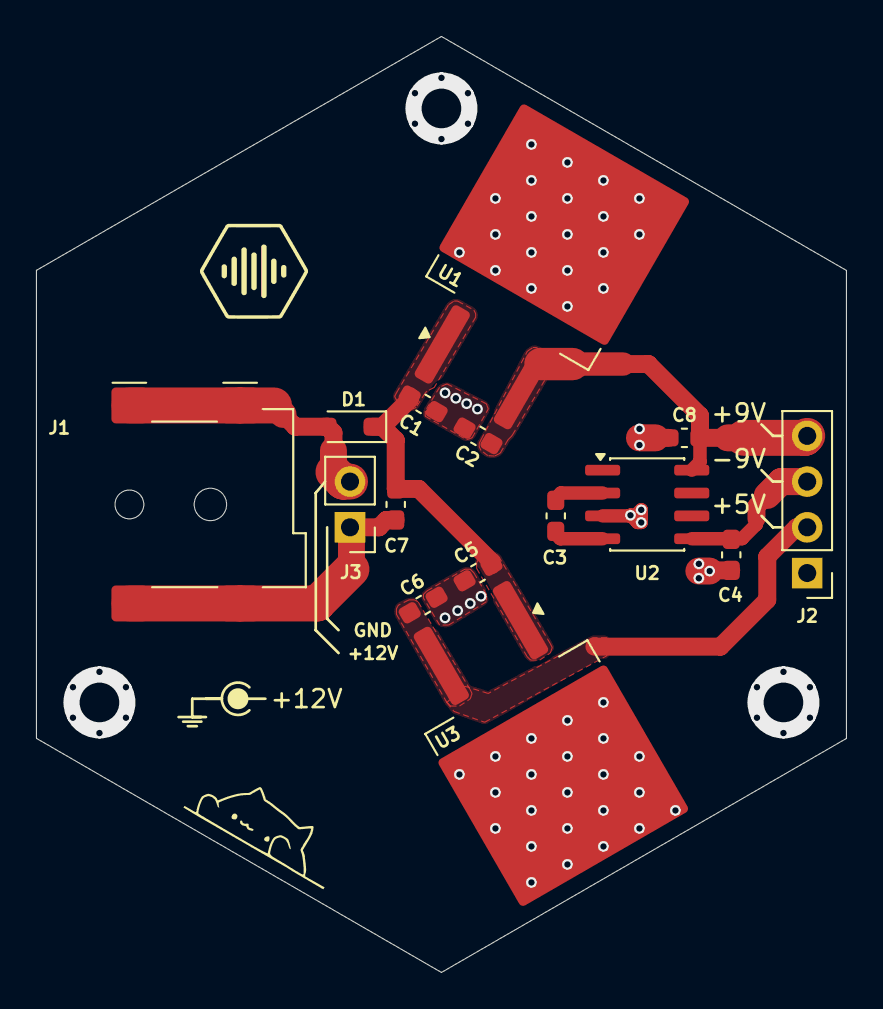
[picture p18: board dcdc.kicad_pcb from above]

Board: 2 copper layers, 45.0 x 52.0 mm, 15 parts (0 on the bottom side), 8 nets.
