Lucaa02/hexatones/ADSR/ADSR.kicad_pcb

## KiCad design ADSR/ADSR.kicad_pcb (2026-11-03)

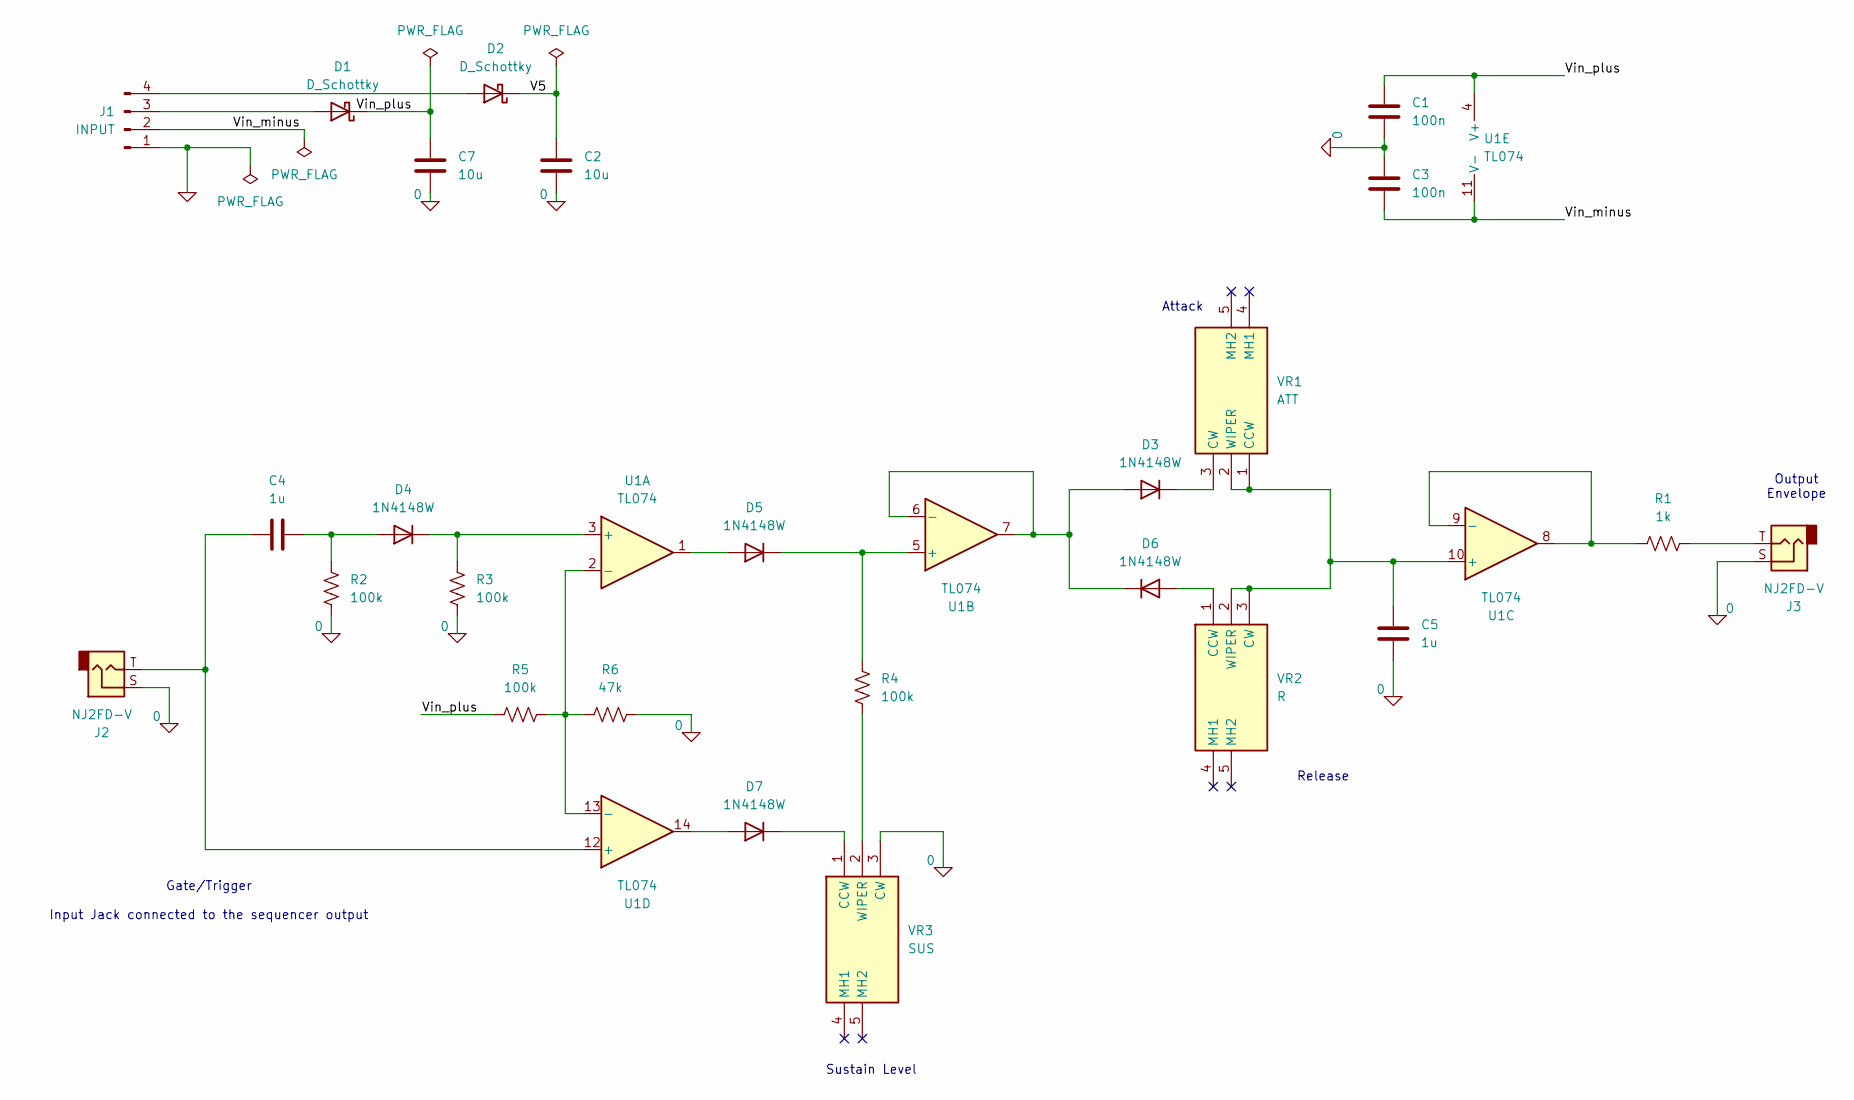
[picture p19: schematic ADSR.kicad_sch]

Parts:
C1, C3: 100n; C_0603_1608Metric_Pad1.08x0.95mm_HandSolder
C2, C7: 10u; C_0603_1608Metric_Pad1.08x0.95mm_HandSolder
C4, C5: 1u; C_0603_1608Metric_Pad1.08x0.95mm_HandSolder
D1, D2: D_Schottky; D_SOD-323_HandSoldering
D3, D4, D5, D6, D7: 1N4148W; D_SOD-123
J1: INPUT; PinHeader_1x04_P2.54mm_Vertical
J2, J3: NJ2FD-V; Jack_3.5mm_QingPu_WQP-PJ398SM_Vertical_CircularHoles
R1: 1k; R_0603_1608Metric_Pad0.98x0.95mm_HandSolder
R2, R3, R4, R5: 100k; R_0603_1608Metric_Pad0.98x0.95mm_HandSolder
R6: 47k; R_0603_1608Metric_Pad0.98x0.95mm_HandSolder
U1: TL074; SOIC-14_3.9x8.7mm_P1.27mm
VR1: ATT; Potentiometer_Alpha_RD901F-40-00D_Single_Vertical; Mouser Part Number 311-1940F-15R1-B100K
VR2: R; Potentiometer_Alpha_RD901F-40-00D_Single_Vertical; Mouser Part Number 311-1940F-15R1-B100K
VR3: SUS; Potentiometer_Alpha_RD901F-40-00D_Single_Vertical; Mouser Part Number 311-1940F-15R1-B100K

Connections:
0: C1.2, C2.2, C3.1, C5.2, C7.2, J1.1, J2.S, J3.S, R2.1, R3.1, R6.2, VR3.3 (CW)
/Vin_minus: C3.2, J1.2, U1.11 (V-)
/Vin_plus: C1.1, C7.1, D1.1 (K), R5.1, U1.4 (V+)
unnamed: C2.1, D2.1 (K)
unnamed: D1.2 (A), J1.3
unnamed: D2.2 (A), J1.4
unnamed: D3.2 (A), D6.1 (K), U1.6 (-), U1.7
unnamed: D3.1 (K), VR1.3 (CW)
unnamed: C4.2, D4.2 (A), R2.2
unnamed: D4.1 (K), R3.2, U1.3 (+)
unnamed: D5.2 (A), U1.1
unnamed: D5.1 (K), R4.2, U1.5 (+)
unnamed: D6.2 (A), VR2.1 (CCW)
unnamed: D7.2 (A), U1.14
unnamed: D7.1 (K), VR3.1 (CCW)
unnamed: J3.T, R1.1
unnamed: R5.2, R6.1, U1.2 (-), U1.13 (-)
unnamed: C5.1, U1.10 (+), VR1.1 (CCW), VR1.2 (WIPER), VR2.2 (WIPER), VR2.3 (CW)
unnamed: R1.2, U1.8, U1.9 (-)
unnamed: C4.1, J2.T, U1.12 (+)
unnamed: R4.1, VR3.2 (WIPER)

Notes on the sheet:
Release
Attack
Sustain Level
Gate/Trigger Input Jack connected to the sequencer output
Output Envelope

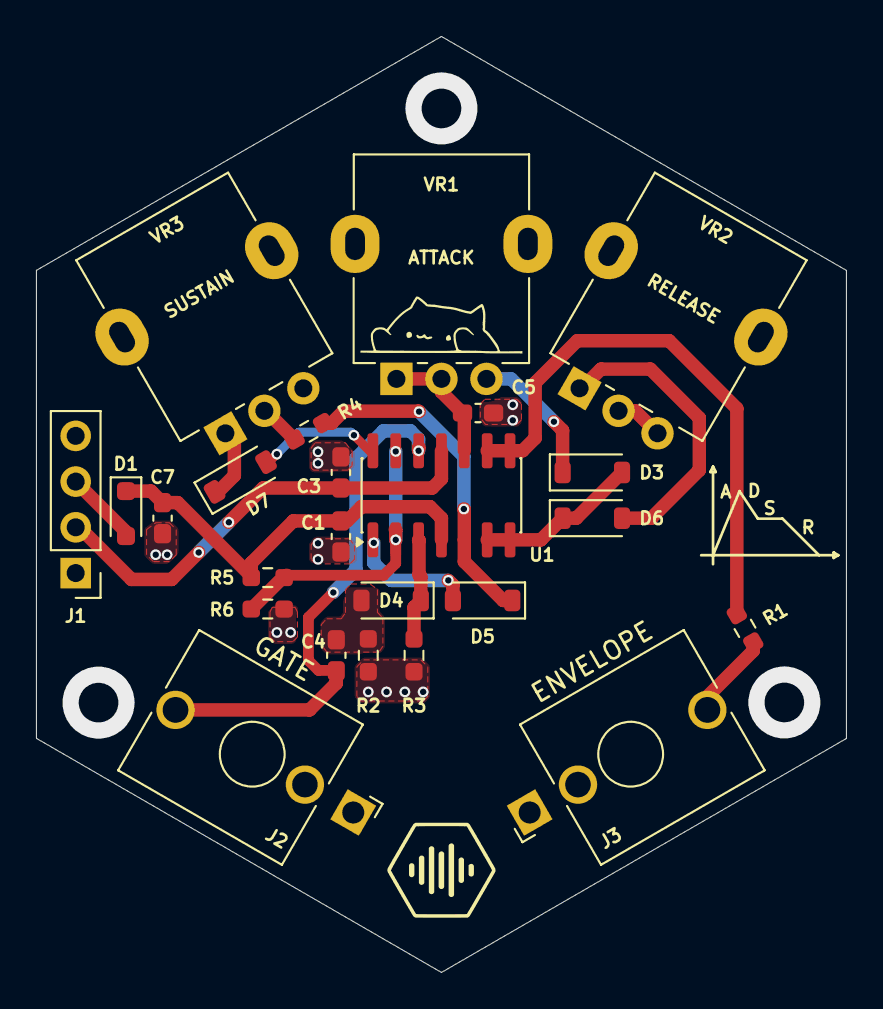
[picture p20: board ADSR.kicad_pcb from above]

Board: 2 copper layers, 45.0 x 52.0 mm, 24 parts (0 on the bottom side), 19 nets.
