Lucaa02/hexatones/mixer/mixer.kicad_pcb

## KiCad design mixer/mixer.kicad_pcb (2026-11-03)

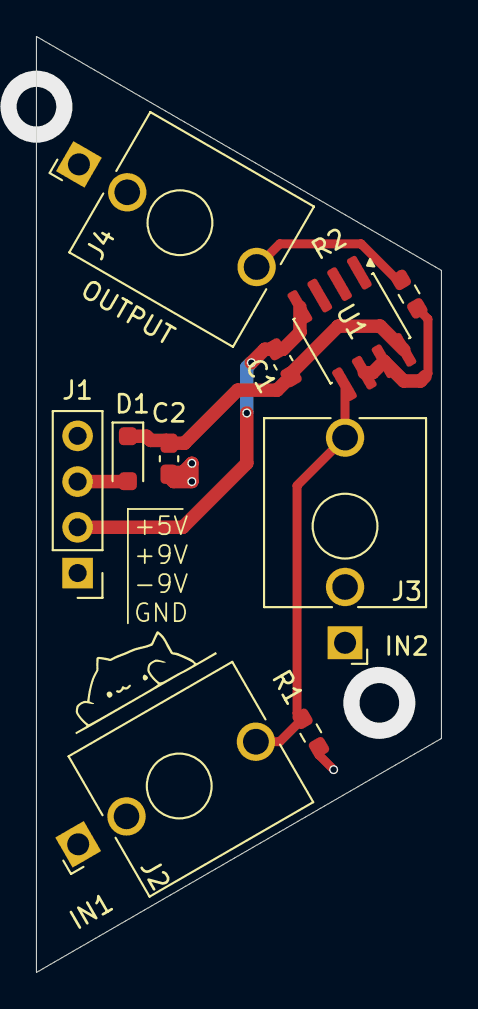
[picture p21: board mixer.kicad_pcb from above]

Board: 2 copper layers, 22.5 x 52.0 mm, 10 parts (0 on the bottom side), 7 nets.

Parts:
C1: 100n; C_0603_1608Metric_Pad1.08x0.95mm_HandSolder
C2: 10u; C_0603_1608Metric_Pad1.08x0.95mm_HandSolder
D1: D_Schottky; D_SOD-323_HandSoldering
J1: INPUT; PinHeader_1x04_P2.54mm_Vertical
J2, J3, J4: NJ2FD-V; Jack_3.5mm_QingPu_WQP-PJ398SM_Vertical_CircularHoles
R1: 100k; R_0603_1608Metric_Pad0.98x0.95mm_HandSolder
R2: 1k; R_0603_1608Metric_Pad0.98x0.95mm_HandSolder
U1: TL072; SOIC-8_3.9x4.9mm_P1.27mm

Connections:
0: C2.2, J1.1, J2.S, J3.S, J4.S, R1.1
/Vin_minus: C1.2, J1.2, U1.4 (V-)
/Vin_plus: C1.1, C2.1, D1.1 (K), U1.8 (V+)
unnamed: D1.2 (A), J1.3
unnamed: J4.T, R2.1
unnamed: J2.T, J3.T, R1.2, U1.5 (+)
unnamed: R2.2, U1.6 (-), U1.7
