Lucaa02/hexatones/(commit log)

2026-10-15 second commit, first failed
    [ADSR.kicad_pcb, ADSR.kicad_sch, LinearToExp.kicad_pcb, LinearToExp.kicad_sch, Oscillator.kicad_pcb, Oscillator.kicad_sch, dcdc.kicad_pcb, dcdc.kicad_sch]
2026-10-16 added the layout of the PCB ADSL
    [ADSR.kicad_pcb]
2026-10-28 added sequencer schematic and schematic of VCA
    [LinearToExp-B_Cu.gbr, LinearToExp-B_Mask.gbr, LinearToExp-B_Paste.gbr, LinearToExp-B_Silkscreen.gbr, LinearToExp-Edge_Cuts.gbr, LinearToExp-F_Cu.gbr, LinearToExp-F_Mask.gbr, LinearToExp-F_Paste.gbr]
2026-10-29 sch pasmix, mix
    [mixer.kicad_pcb, mixer.kicad_sch, passivemixer.kicad_pcb, passivemixer.kicad_sch, sequencer.kicad_sch]
2026-11-01 fixing ADSR and DCDC
    [ADSR-B_Cu.gbr, ADSR-B_Mask.gbr, ADSR-B_Paste.gbr, ADSR-B_Silkscreen.gbr, ADSR-Edge_Cuts.gbr, ADSR-F_Cu.gbr, ADSR-F_Mask.gbr, ADSR-F_Paste.gbr]
2026-11-01 adsr and dc dc fix
    [dcdc-B_Cu.gbr, dcdc-B_Mask.gbr, dcdc-B_Paste.gbr, dcdc-B_Silkscreen.gbr, dcdc-Edge_Cuts.gbr, dcdc-F_Cu.gbr, dcdc-F_Mask.gbr, dcdc-F_Paste.gbr]
2026-11-01 ready to production version of the VCO and the 1V/EXp
    [LinearToExp.kicad_pcb, LinearToExp.kicad_sch, Oscillator.kicad_pcb, sequencer.kicad_sch]
2026-11-03 VCA layout, CLK design + layout
    [ADSR.kicad_pcb, LinearToExp.kicad_pcb, Oscillator.kicad_pcb, clk.kicad_pcb, clk.kicad_sch, dcdc.kicad_pcb, mixer.kicad_pcb, mixer.kicad_sch]
2026-11-05 sequencer PCB
    [sequencer.kicad_pcb, sequencer.kicad_sch]
